BrainOnFire/PCBFiles_Node/PCBFiles_Node.kicad_pcb

## KiCad design PCBFiles_Node.kicad_pcb (2022-12-01)

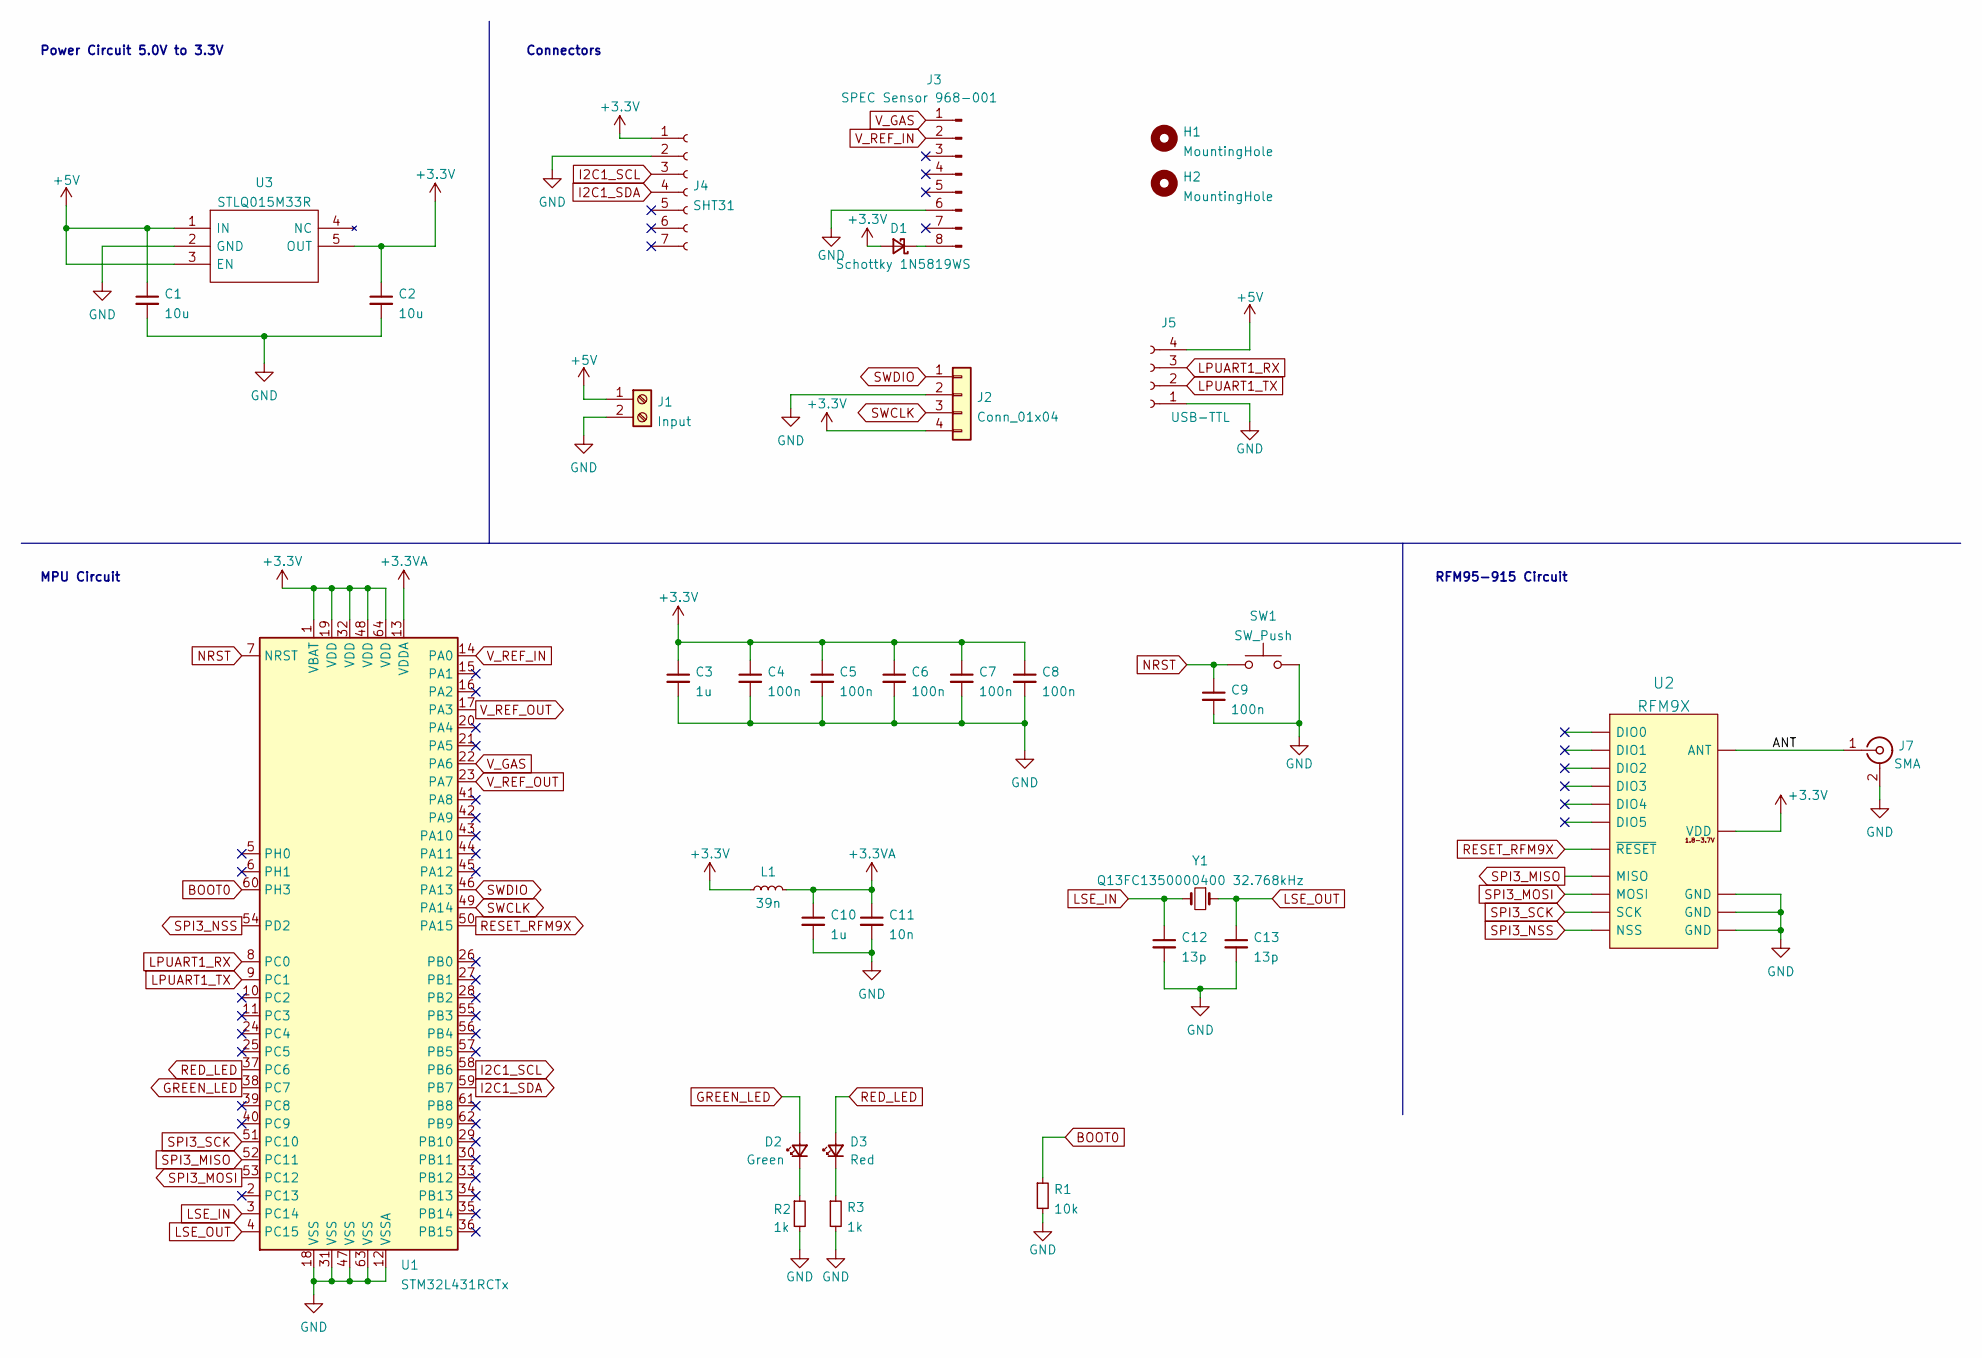
[picture p1: schematic PCBFiles_Node.kicad_sch, Diseño PCB Nodo Sensor Version 2.0]

Parts:
C1, C2: 10u; C_1206_3216Metric; LCSC Part # C13585
C3, C10: 1u; C_0402_1005Metric; LCSC Part # C52923
C4, C5, C6, C7, C8, C9: 100n; C_0402_1005Metric; LCSC Part # C307331
C11: 10n; C_0402_1005Metric; LCSC Part # C15195
C12, C13: 13p; C_0402_1005Metric; LCSC Part # C48936
D1: Schottky 1N5819WS; D_SOD-323; LCSC Part # C191023
D2: Green; LED_0603_1608Metric; LCSC Part # C118334
D3: Red; LED_0603_1608Metric; LCSC Part # C118330
H1, H2: MountingHole; MountingHole_2.2mm_M2_Pad
J1: Input; TerminalBlock_bornier-2_P5.08mm
J2: Conn_01x04; PinSocket_1x04_P2.54mm_Vertical
J3: SPEC Sensor 968-001; PinHeader_1x08_P2.54mm_Horizontal
J4: SHT31; PinSocket_1x07_P2.54mm_Vertical
J5: USB-TTL; PinSocket_1x04_P2.54mm_Horizontal
J7: SMA; SMA_Samtec_SMA-J-P-X-ST-EM1_EdgeMount
L1: 39n; L_0402_1005Metric; LCSC Part # C335623
R1: 10k; R_0402_1005Metric; LCSC Part # C25744
R2, R3: 1k; R_0603_1608Metric; LCSC Part # C21190
SW1: SW_Push; SW_SPST_B3U-1000P; LCSC Part # B3U-1000P
U1: STM32L431RCTx; LQFP-64_10x10mm_P0.5mm; LCSC Part # C92468
U2: RFM9X; RFM9X-SMD; LCSC Part # C2844473
U3: STLQ015M33R; SOT95P280X145-5N; Mouser Part Number 511-STLQ015M33R
Y1: Q13FC1350000400 32.768kHz; Q13FC1350000400; LCSC Part # C32346

Connections:
+3.3VA: C10.1, C11.1, L1.2, U1.13 (VDDA)
+3V3: C2.1, C3.1, C4.1, C5.1, C6.1, C7.1, C8.1, D1.2 (A), J2.4, J4.1, L1.1, U1.1 (VBAT), U1.19 (VDD), U1.32 (VDD), U1.48 (VDD), U1.64 (VDD), U2.12 (VDD), U3.5 (OUT)
+5V: C1.1, J1.1, J5.4, U3.1 (IN), U3.3 (EN)
/ANT: J7.1 (In), U2.16 (ANT)
BOOT0: R1.1, U1.60 (PH3)
GND: C1.2, C2.2, C3.2, C4.2, C5.2, C6.2, C7.2, C8.2, C9.2, C10.2, C11.2, C12.2, C13.2, J1.2, J2.2, J3.6, J4.2, J5.1, J7.2 (Ext), R1.2, R2.2, R3.2, SW1.2, U1.12 (VSSA), U1.18 (VSS), U1.31 (VSS), U1.47 (VSS), U1.63 (VSS), U2.1 (GND), U2.8 (GND), U2.15 (GND), U3.2 (GND)
GREEN_LED: D2.2 (A), U1.38 (PC7)
I2C1_SCL: J4.3, U1.58 (PB6)
I2C1_SDA: J4.4, U1.59 (PB7)
LPUART1_RX: J5.3, U1.8 (PC0)
LPUART1_TX: J5.2, U1.9 (PC1)
LSE_IN: C12.1, U1.3 (PC14), Y1.2
LSE_OUT: C13.1, U1.4 (PC15), Y1.1
NRST: C9.1, SW1.1, U1.7 (NRST)
unnamed: D1.1 (K), J3.8
unnamed: D2.1 (K), R2.1
unnamed: D3.1 (K), R3.1
RED_LED: D3.2 (A), U1.37 (PC6)
RESET_RFM9X: U1.50 (PA15), U2.6 (~RESET)
SPI3_MISO: U1.52 (PC11), U2.2 (MISO)
SPI3_MOSI: U1.53 (PC12), U2.3 (MOSI)
SPI3_NSS: U1.54 (PD2), U2.5 (NSS)
SPI3_SCK: U1.51 (PC10), U2.4 (SCK)
SWCLK: J2.3, U1.49 (PA14)
SWDIO: J2.1, U1.46 (PA13)
V_GAS: J3.1, U1.22 (PA6)
V_REF_IN: J3.2, U1.14 (PA0)
V_REF_OUT: U1.17 (PA3), U1.23 (PA7)

Notes on the sheet:
RFM95-915 Circuit
MPU Circuit
Connectors
Power Circuit 5.0V to 3.3V

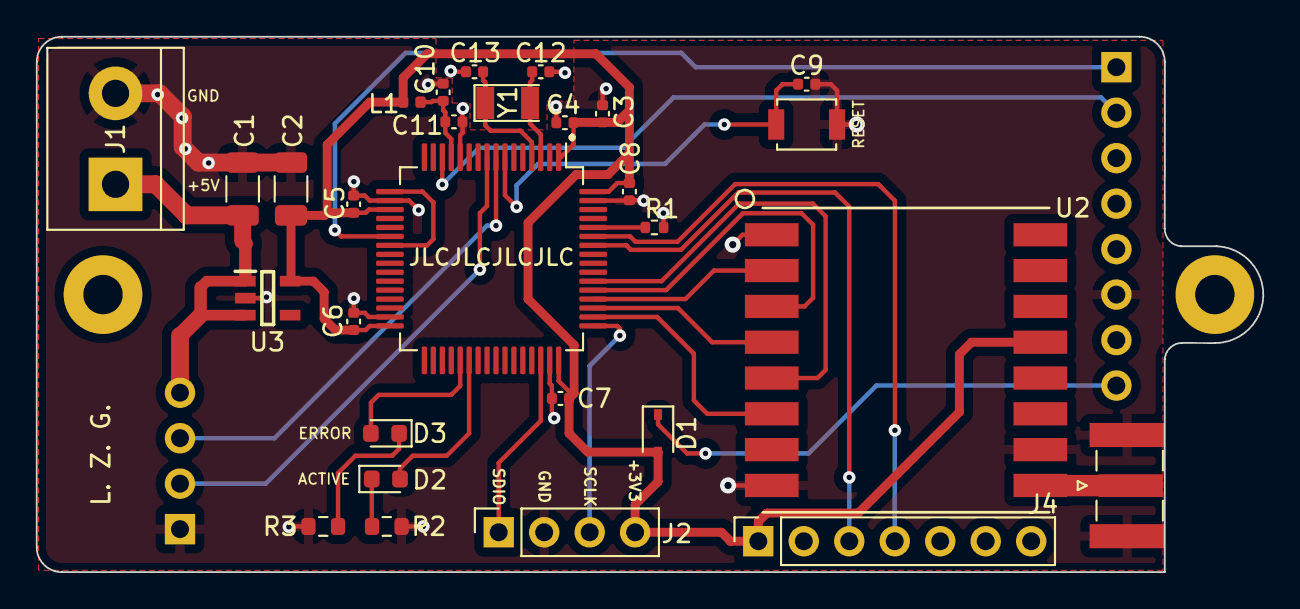
[picture p2: board PCBFiles_Node.kicad_pcb from above]

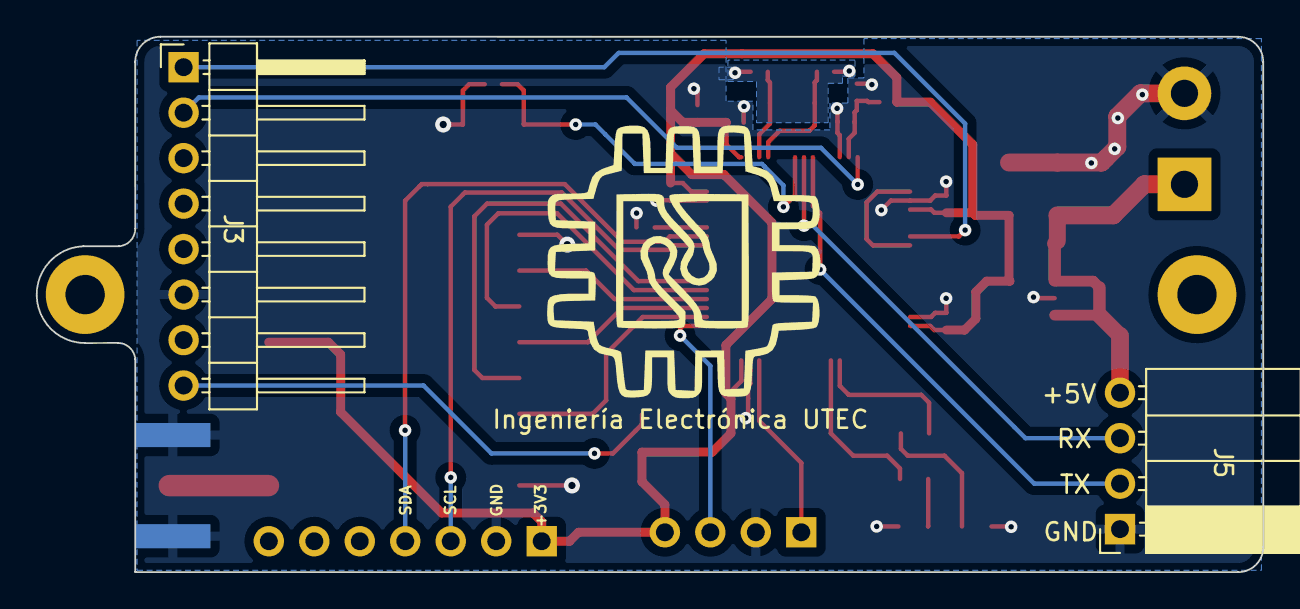
[picture p3: board PCBFiles_Node.kicad_pcb from below]

Board: 2 copper layers, 68.5 x 29.9 mm, 33 parts (2 on the bottom side), 28 nets.
