BrainOnFire/PCBFiles_Node/(commit log)

2022-09-12 Added files to first commit
    [PCBFiles_Node.kicad_pcb, PCBFiles_Node.kicad_sch]
2022-09-12 Prueba de push nro. 2
    [PCBFiles_Node.kicad_sch]
2022-09-12 Prueba push Nro.3
    [PCBFiles_Node.kicad_sch]
2022-09-13 Prueba 4
    [PCBFiles_Node.kicad_pcb, PCBFiles_Node.kicad_sch]
2022-09-14 STM32 IC
    [PCBFiles_Node.kicad_pcb, PCBFiles_Node.kicad_sch]
2022-09-20 Voltage regulator, Crystal, RFM9x, base settings
    [PCBFiles_Node.kicad_pcb, PCBFiles_Node.kicad_sch]
2022-09-22 Connectors, MPU Circuit & Pins Schematic Update
    [PCBFiles_Node.kicad_pcb, PCBFiles_Node.kicad_sch]
2022-09-26 First PCB Design
    [PCBFiles_Node.kicad_pcb, PCBFiles_Node.kicad_sch]
2022-09-30 Replaced STM32L432KCU6 for STM32L431RCTx in Schematic and PCB
    [PCBFiles_Node.kicad_pcb, PCBFiles_Node.kicad_sch]
2022-10-02 First routing
    [PCBFiles_Node-B_Cu.gbr, PCBFiles_Node-B_Mask.gbr, PCBFiles_Node-B_Paste.gbr, PCBFiles_Node-B_Silkscreen.gbr, PCBFiles_Node-Edge_Cuts.gbr, PCBFiles_Node-F_Cu.gbr, PCBFiles_Node-F_Mask.gbr, PCBFiles_Node-F_Paste.gbr]
2022-10-05 Minor changes
    [PCBFiles_Node-B_Cu.gbr, PCBFiles_Node-B_Mask.gbr, PCBFiles_Node-B_Paste.gbr, PCBFiles_Node-B_Silkscreen.gbr, PCBFiles_Node-Edge_Cuts.gbr, PCBFiles_Node-F_Cu.gbr, PCBFiles_Node-F_Mask.gbr, PCBFiles_Node-F_Paste.gbr]
2022-10-14 Gerber and Fab files
    [PCBFiles_Node-B_Cu.gbr, PCBFiles_Node-B_Mask.gbr, PCBFiles_Node-B_Paste.gbr, PCBFiles_Node-B_Silkscreen.gbr, PCBFiles_Node-Edge_Cuts.gbr, PCBFiles_Node-F_Cu.gbr, PCBFiles_Node-F_Mask.gbr, PCBFiles_Node-F_Paste.gbr]
2022-12-01 Via Parameters Changed
    [PCBFiles_Node-B_Cu.gbr, PCBFiles_Node-B_Mask.gbr, PCBFiles_Node-B_Paste.gbr, PCBFiles_Node-B_Silkscreen.gbr, PCBFiles_Node-Edge_Cuts.gbr, PCBFiles_Node-F_Cu.gbr, PCBFiles_Node-F_Mask.gbr, PCBFiles_Node-F_Paste.gbr]
